garv-patidar/LAM-Research-Challenge/Technical Documents/Mechanical Drawings.pdf

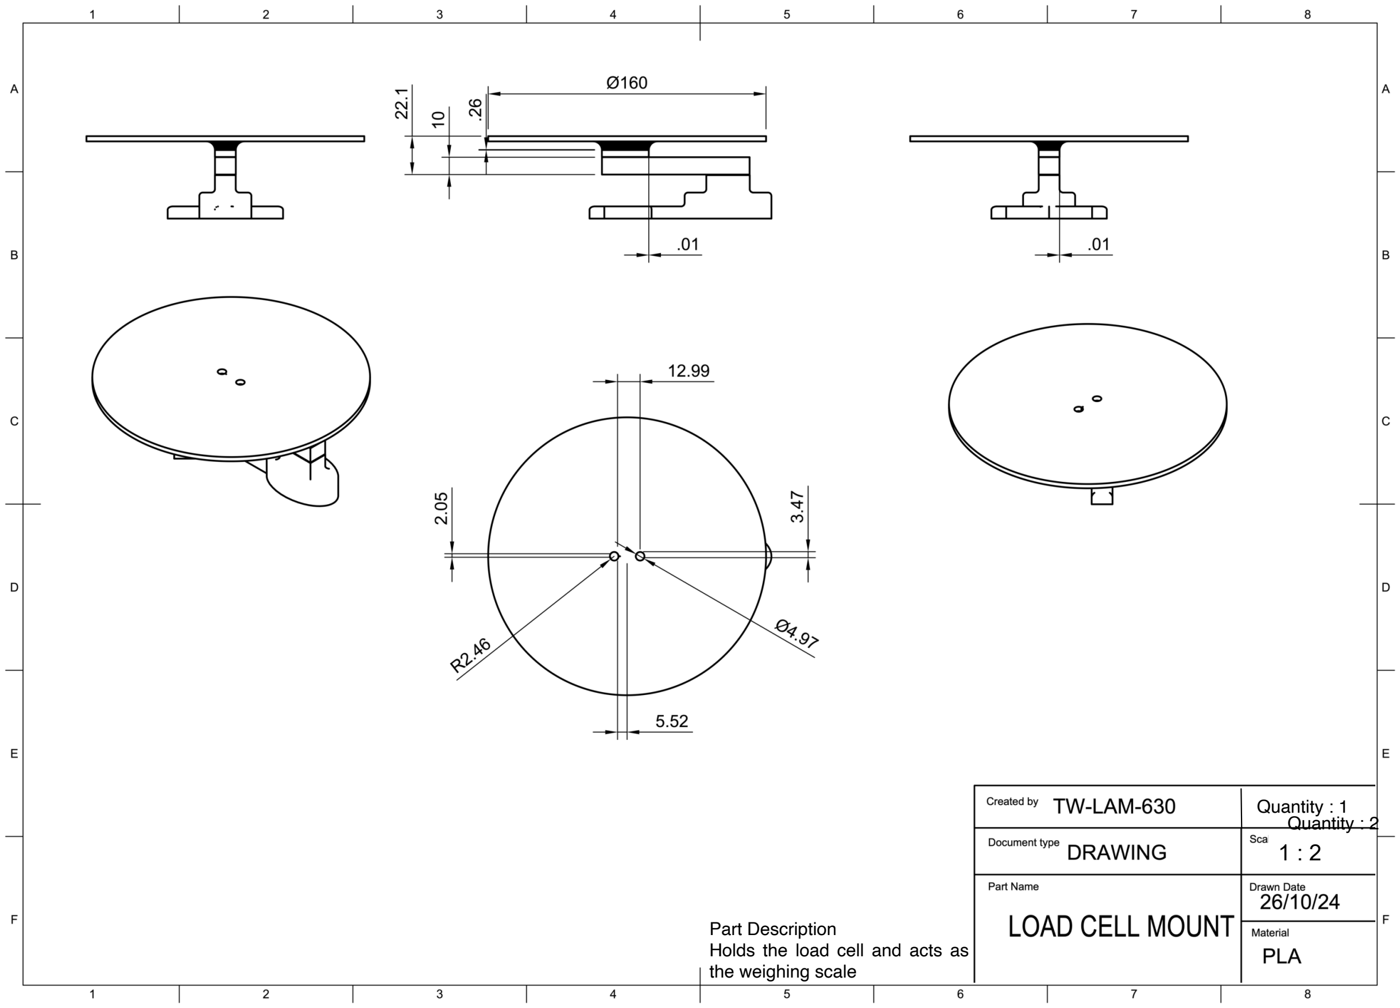
[picture p1: page 1]

1 : 2

1

A

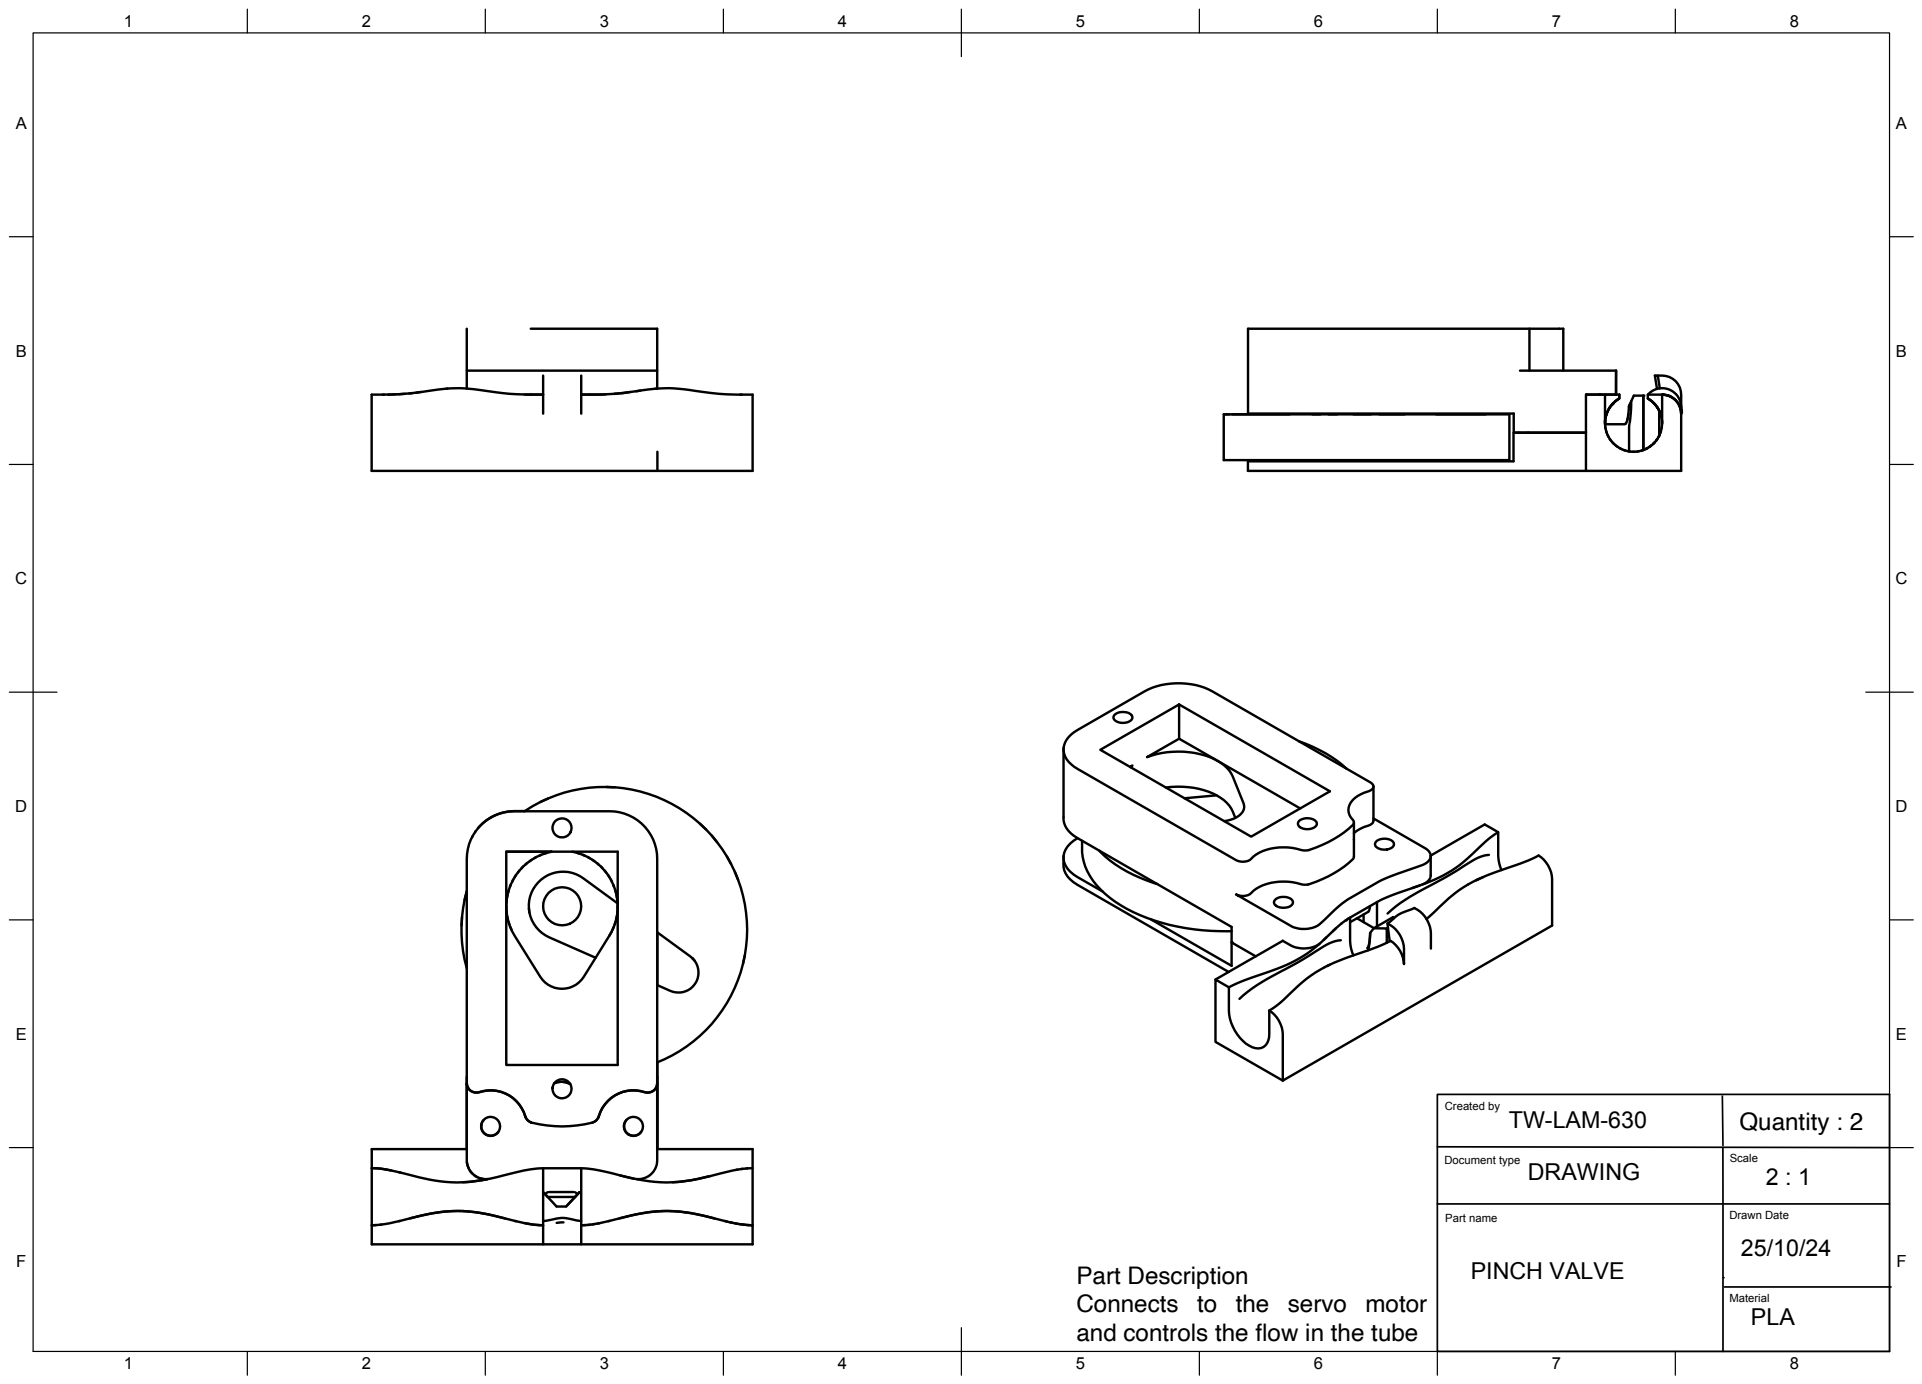
[picture p2: page 2]
Created by; Document type; Part name; Scale; Drawn Date; Material; TW-LAM-630; DRAWING; PINCH VALVE; PLA

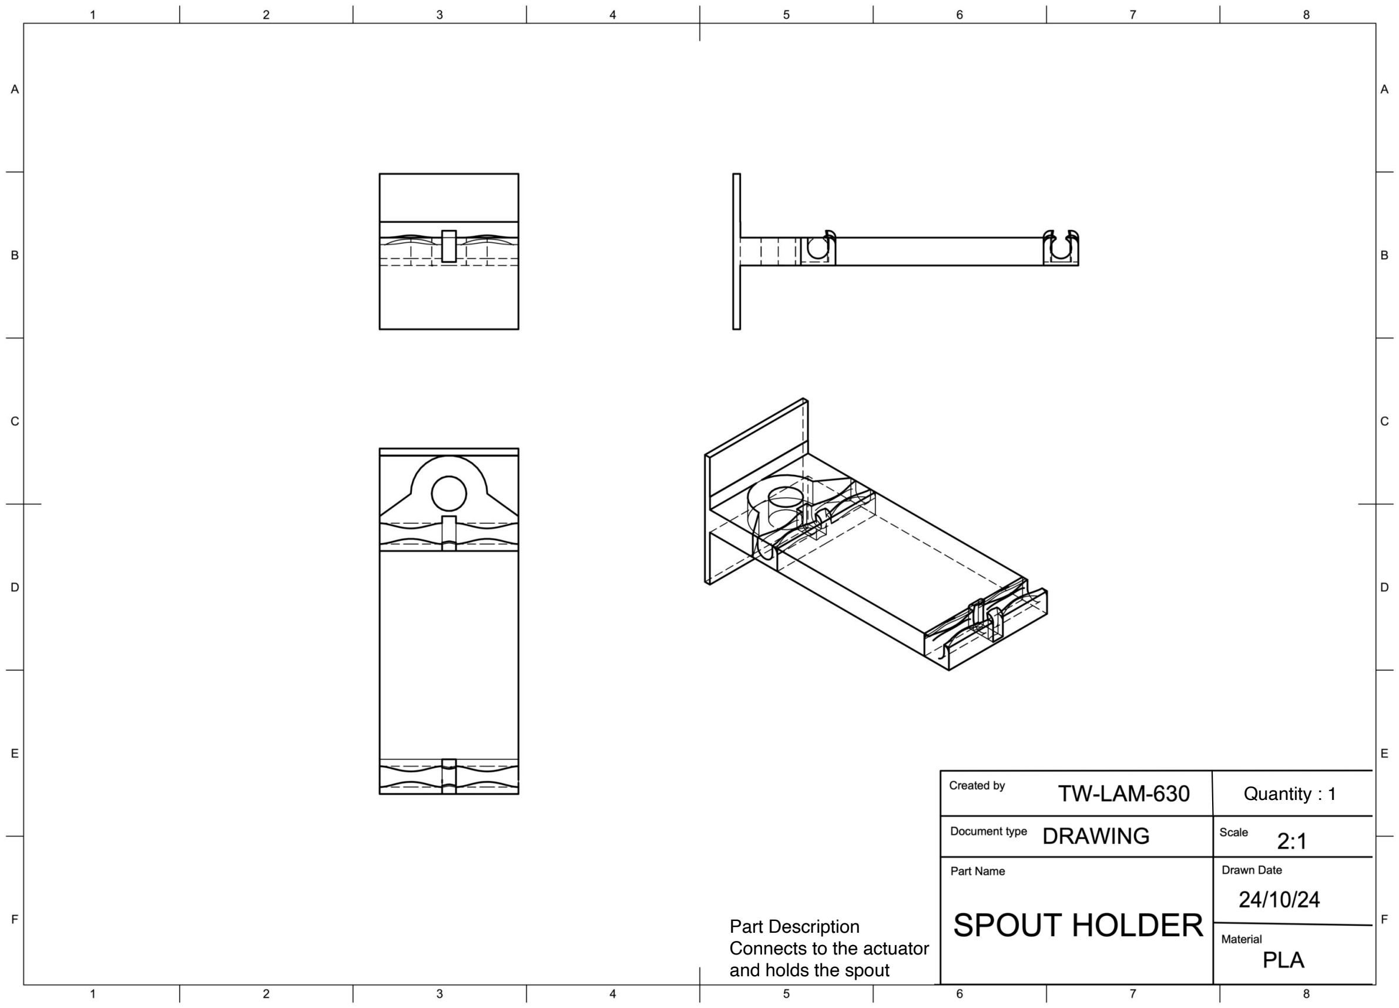
[picture p3: page 3]
