garv-patidar/LAM-Research-Challenge/Technical Documents/Process Flow Chart.pdf

# Process Flow Chart

## Start

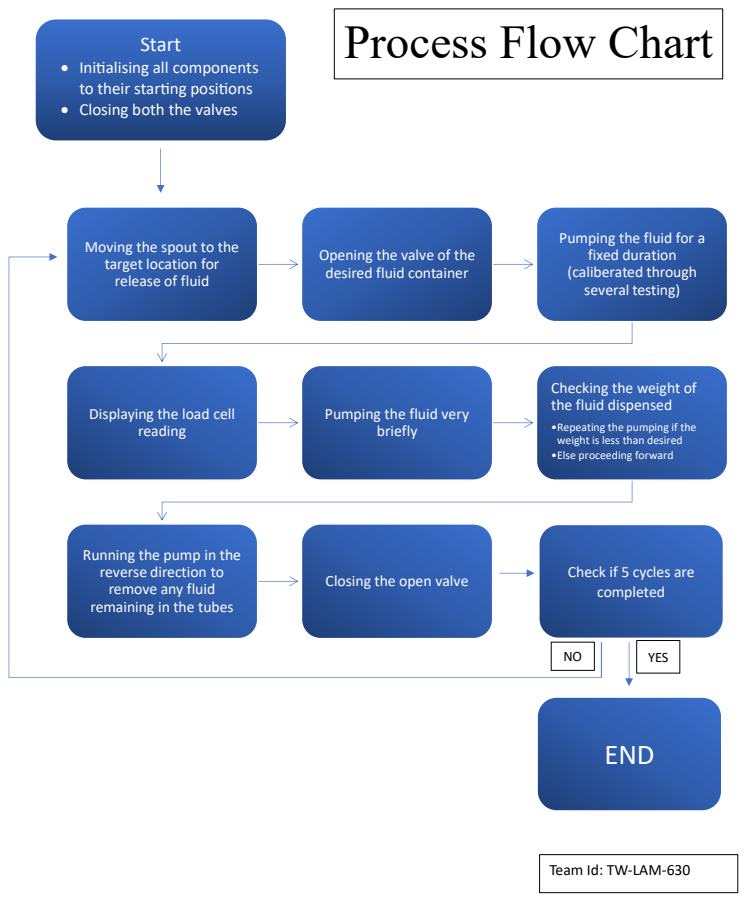
[picture p4: page 1]
reading; briefly; END; YES

• Initialising all components
to their starting positions
• Closing both the valves

Pumping the fluid for a
fixed duration
(caliberated through
several testing)

Moving the spout to the
target location for
release of fluid

Opening the valve of the
desired fluid container

Checking the weight of
the fluid dispensed

Displaying the load cell

Pumping the fluid very

•Repeating the pumping if the
weight is less than desired
•Else proceeding forward

Running the pump in the
reverse direction to
remove any fluid
remaining in the tubes

Check if 5 cycles are
completed

Closing the open valve

Team Id: TW-LAM-630
