garv-patidar/LAM-Research-Challenge/Technical Documents/Wiring Diagram.pdf

# Wiring Diagram

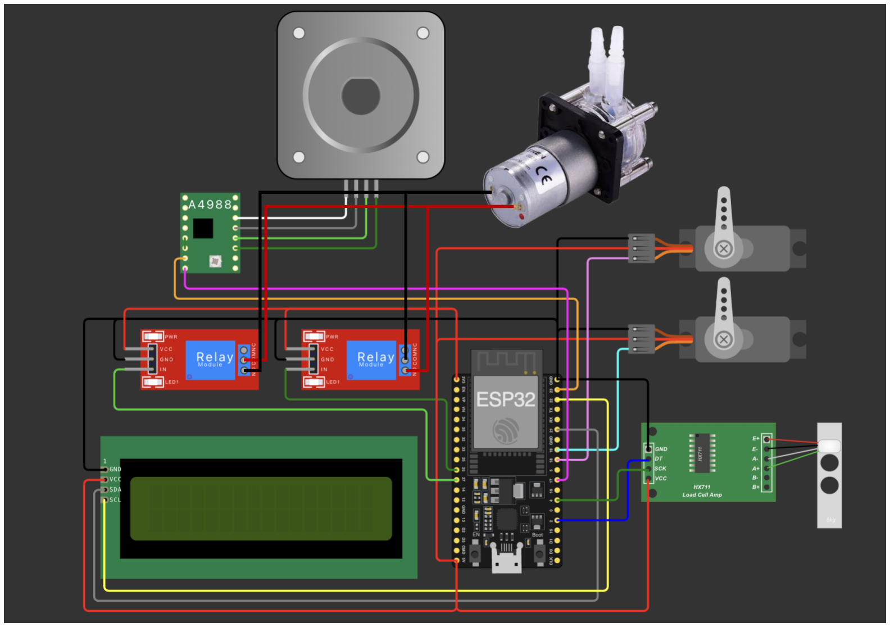
[picture p5: figure]

Team Id: TW-LAM-630
Made using Wokwi
